NguyenQBao/UBHacking2026-MERC.SWEEPY/software/metalsweep-control/requirements-model.txt

# Install in a --system-site-packages venv on Raspberry Pi OS; apt supplies Picamera2/OpenCV/GPIO.
ultralytics==8.4.194
