NguyenQBao/UBHacking2026-MERC.SWEEPY/docs/concept/metalsweep-metal-robot-concept.png

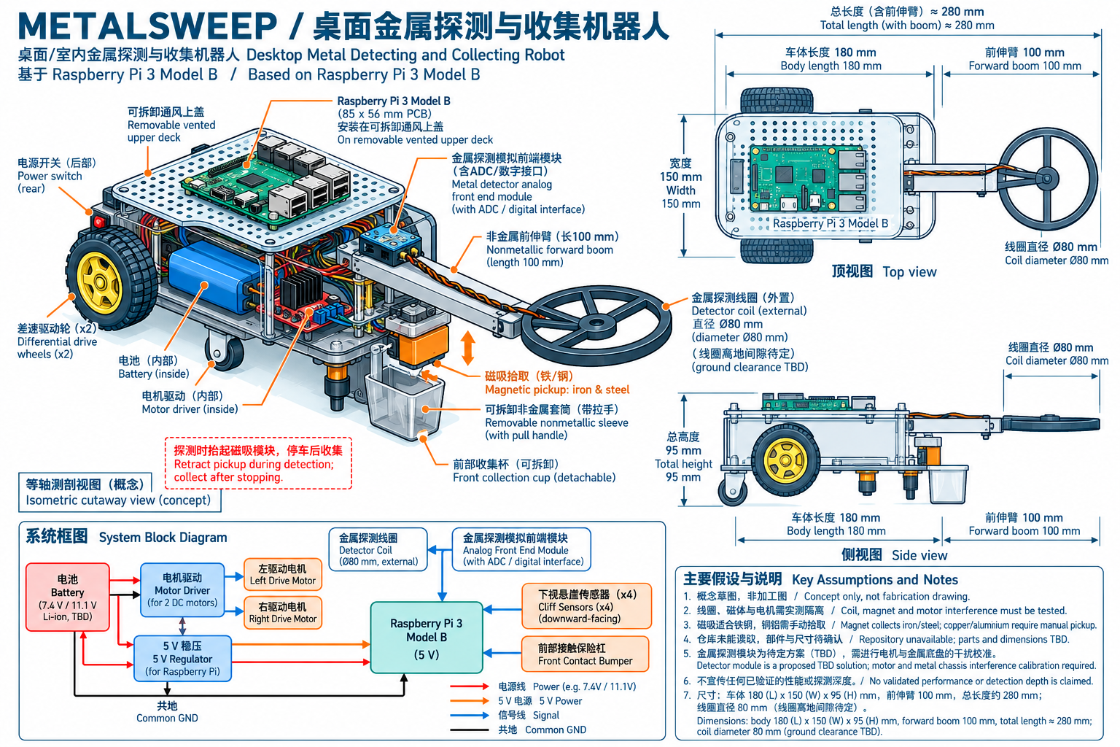
docs/concept/metalsweep-metal-robot-concept.png
