NguyenQBao/UBHacking2026-MERC.SWEEPY/docs/poster/system-flow.png

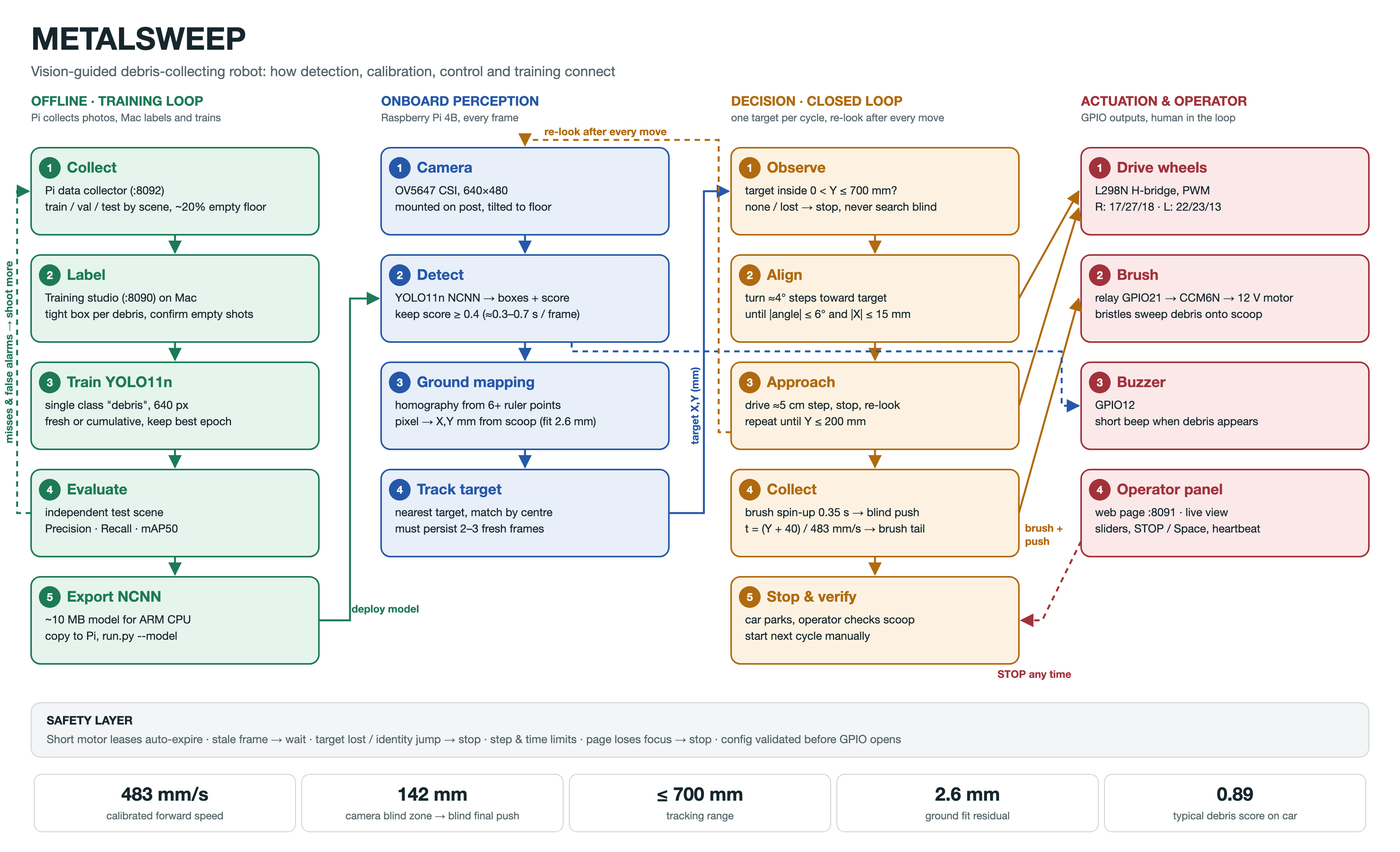
docs/poster/system-flow.png
