NguyenQBao/UBHacking2026-MERC.SWEEPY/hardware/brush-collector-v3/parts_preview.png

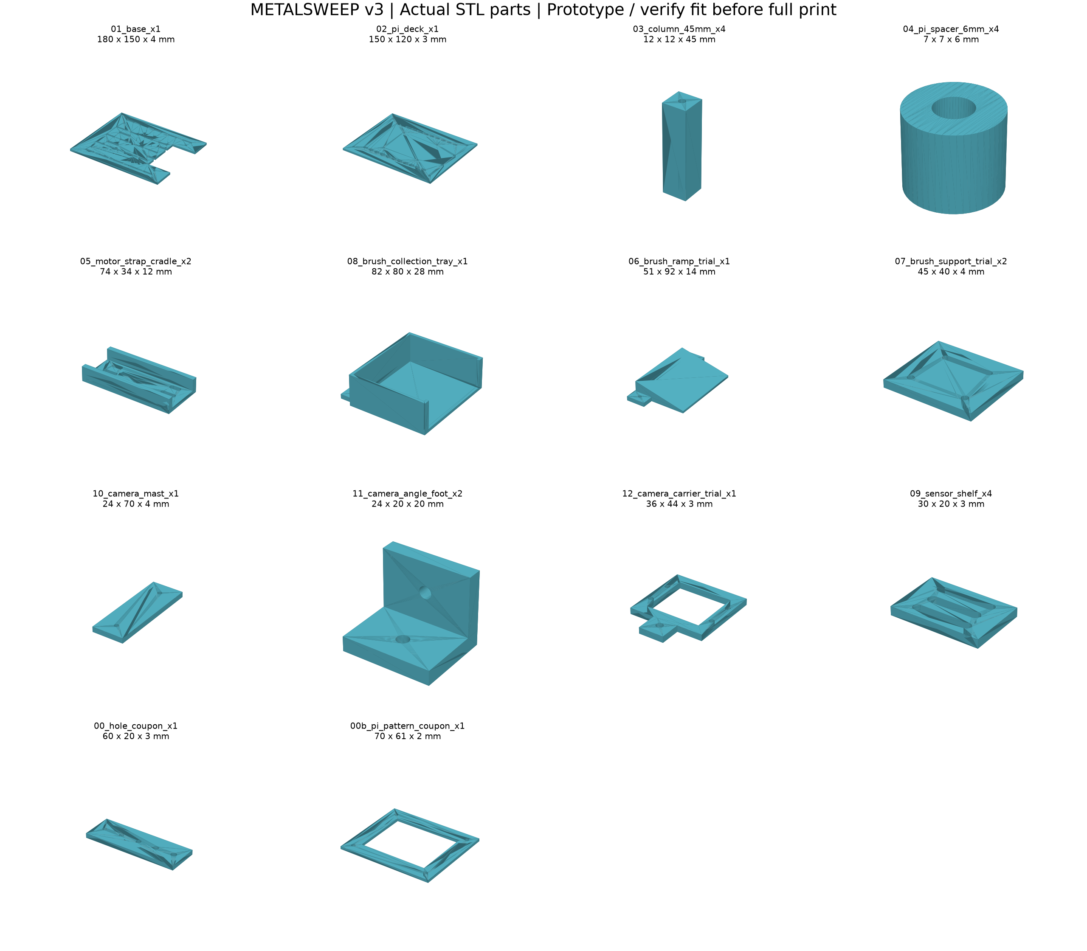
hardware/brush-collector-v3/parts_preview.png
