NguyenQBao/UBHacking2026-MERC.SWEEPY/hardware/cad-v8/ramp-main.stl

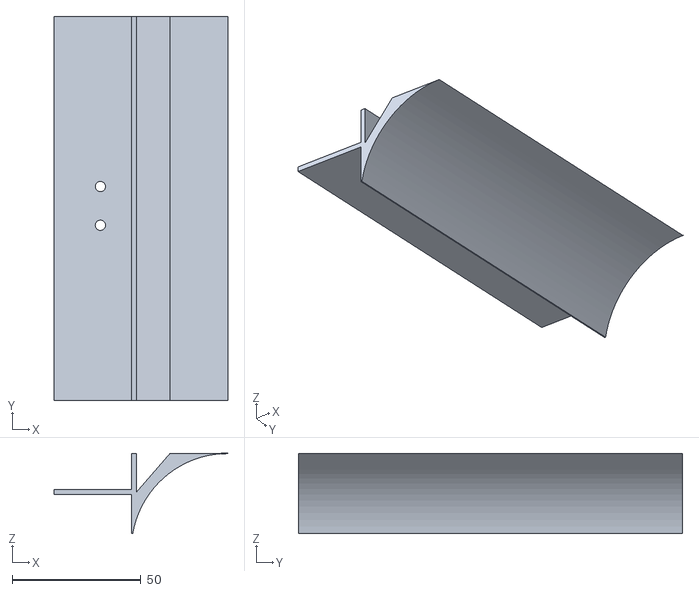
[picture p5: CAD file, 2026-11-06]
hardware/cad-v8/ramp-main.stl
67.5 x 149.0 x 31.1
