NguyenQBao/UBHacking2026-MERC.SWEEPY/hardware/cad-v8/metal-storage-main.stl

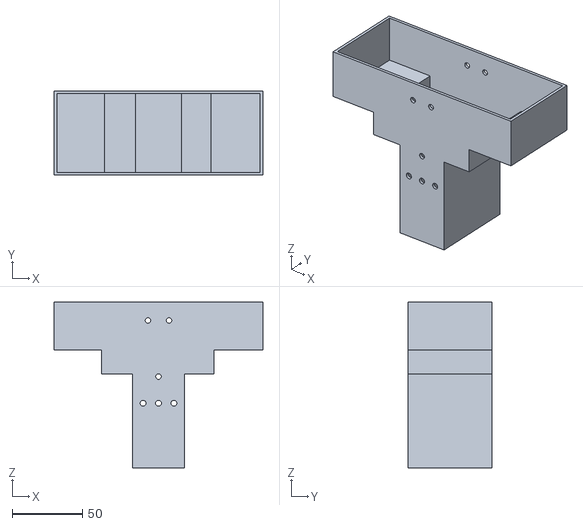
[picture p6: CAD file, 2026-11-06]
hardware/cad-v8/metal-storage-main.stl
149.0 x 60.0 x 118.0
