NguyenQBao/UBHacking2026-MERC.SWEEPY/hardware/cad-v8/shaft-main.stl

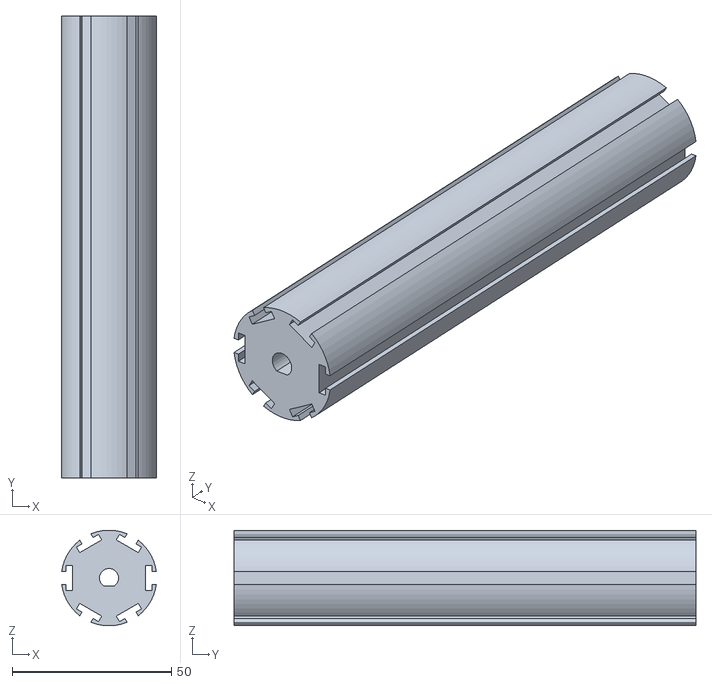
[picture p7: CAD file, 2026-11-06]
hardware/cad-v8/shaft-main.stl
29.7 x 145.0 x 30.0
