NguyenQBao/UBHacking2026-MERC.SWEEPY/hardware/brush-collector-v3/07_brush_support_trial_x2.stl

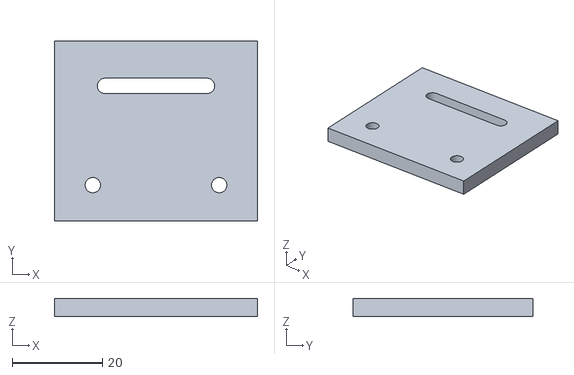
[picture p8: CAD file, 2026-11-05]
hardware/brush-collector-v3/07_brush_support_trial_x2.stl
45.0 x 40.0 x 4.00
