NguyenQBao/UBHacking2026-MERC.SWEEPY/hardware/cad-v8/camera-holder-vertical.stl

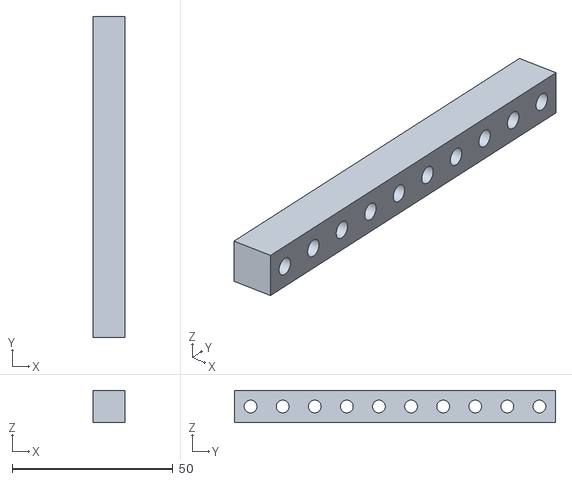
[picture p9: CAD file, 2026-11-06]
hardware/cad-v8/camera-holder-vertical.stl
10.0 x 100.0 x 10.0
