NguyenQBao/UBHacking2026-MERC.SWEEPY/hardware/camera-slot-mount/camera-slot-mount-variants.3mf

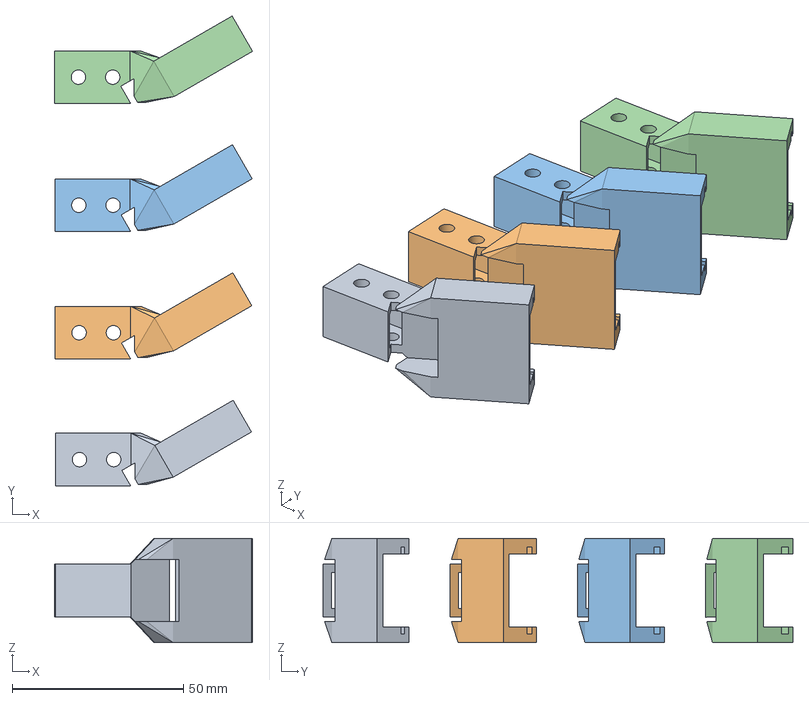
[picture p10: CAD file, 2026-11-07]
hardware/camera-slot-mount/camera-slot-mount-variants.3mf
57.8 x 137.2 x 30.4 mm
camera-slot-mount-slot1.2mm
camera-slot-mount-slot1.6mm
camera-slot-mount-slot2.0mm
camera-slot-mount-slot2.4mm
