NguyenQBao/UBHacking2026-MERC.SWEEPY/hardware/camera-slot-mount/variants/camera-slot-mount-slot1.6mm.stl

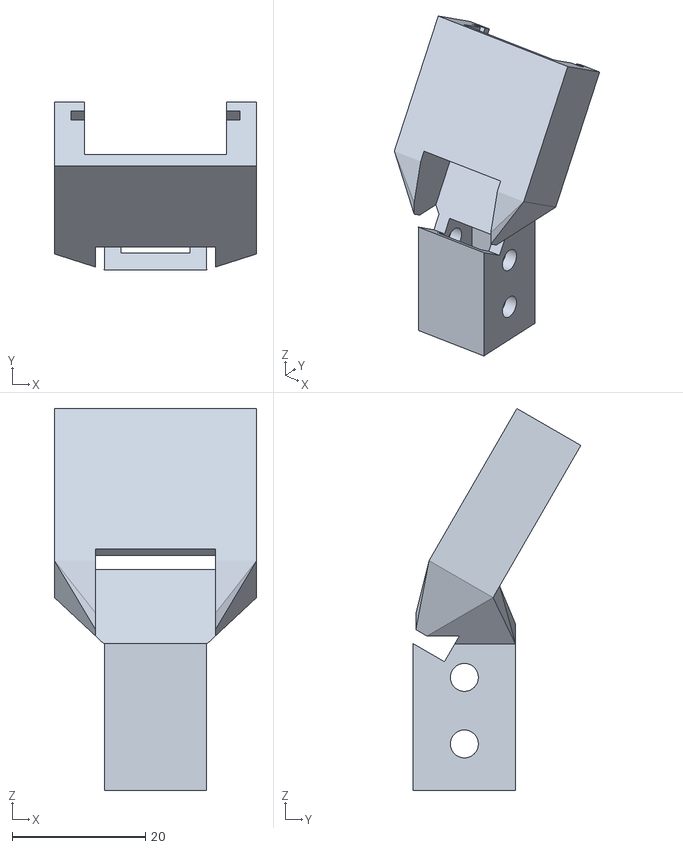
[picture p11: CAD file, 2026-11-07]
hardware/camera-slot-mount/variants/camera-slot-mount-slot1.6mm.stl
30.4 x 25.2 x 57.4
