NguyenQBao/UBHacking2026-MERC.SWEEPY/hardware/brush-collector-v3/01_base_x1.stl

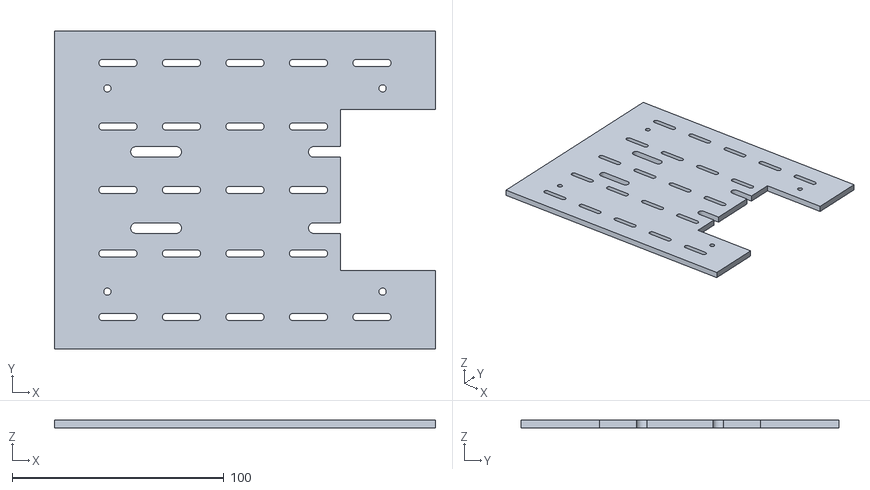
[picture p12: CAD file, 2026-11-05]
hardware/brush-collector-v3/01_base_x1.stl
180.0 x 150.0 x 4.00
