NguyenQBao/UBHacking2026-MERC.SWEEPY/hardware/camera-mount-v7/07_camera_edge_shim_0p4_optional.stl

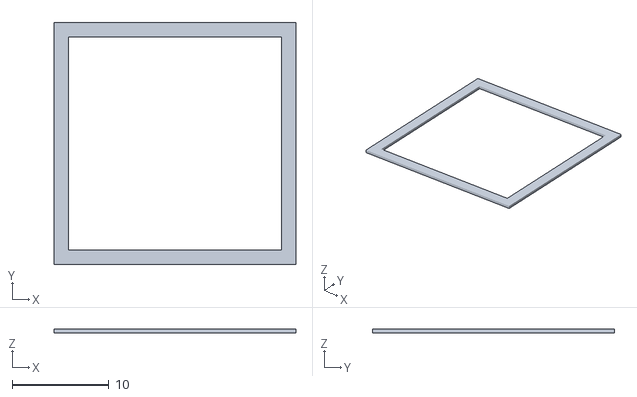
[picture p13: CAD file, 2026-11-05]
hardware/camera-mount-v7/07_camera_edge_shim_0p4_optional.stl
25.0 x 25.0 x 0.4
