NguyenQBao/UBHacking2026-MERC.SWEEPY/hardware/camera-slot-mount/variants/camera-slot-mount-slot2.4mm.stl

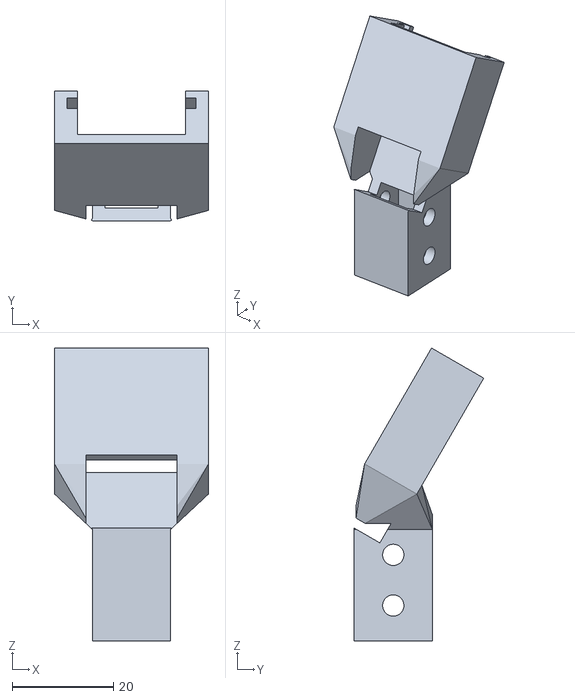
[picture p14: CAD file, 2026-11-07]
hardware/camera-slot-mount/variants/camera-slot-mount-slot2.4mm.stl
30.4 x 25.6 x 57.8
