NguyenQBao/UBHacking2026-MERC.SWEEPY/hardware/brush-collector-v3/09_sensor_shelf_x4.stl

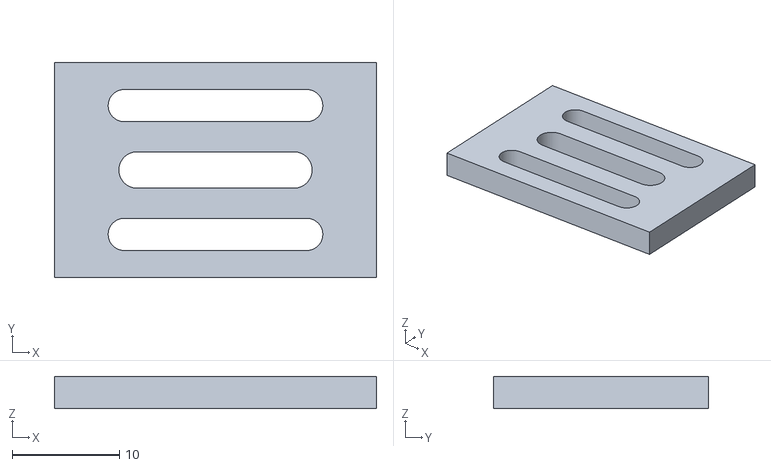
[picture p15: CAD file, 2026-11-05]
hardware/brush-collector-v3/09_sensor_shelf_x4.stl
30.0 x 20.0 x 3.00
