NguyenQBao/UBHacking2026-MERC.SWEEPY/hardware/brush-collector-v3/12_camera_carrier_trial_x1.stl

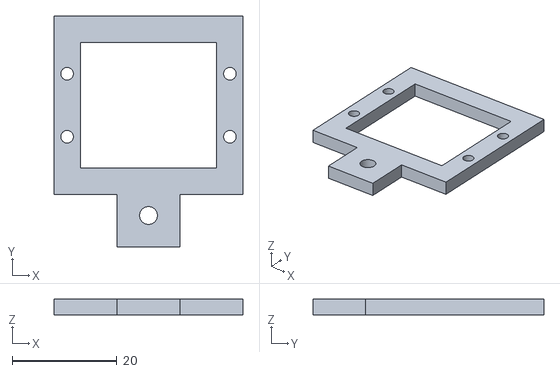
[picture p17: CAD file, 2026-11-05]
hardware/brush-collector-v3/12_camera_carrier_trial_x1.stl
36.0 x 44.0 x 3.00
