NguyenQBao/UBHacking2026-MERC.SWEEPY/hardware/camera-slot-mount/variants/camera-slot-mount-slot2.0mm.stl

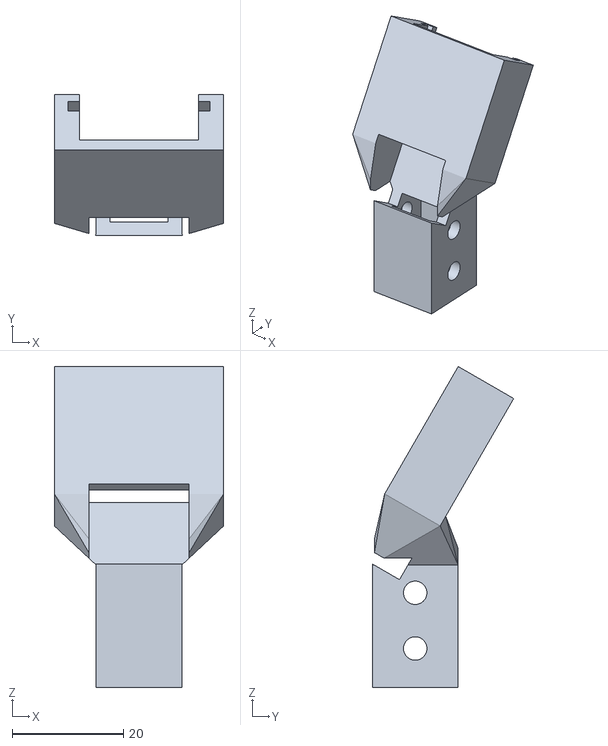
[picture p18: CAD file, 2026-11-07]
hardware/camera-slot-mount/variants/camera-slot-mount-slot2.0mm.stl
30.4 x 25.4 x 57.6
