NguyenQBao/UBHacking2026-MERC.SWEEPY/hardware/brush-collector-v3/10_camera_mast_x1.stl

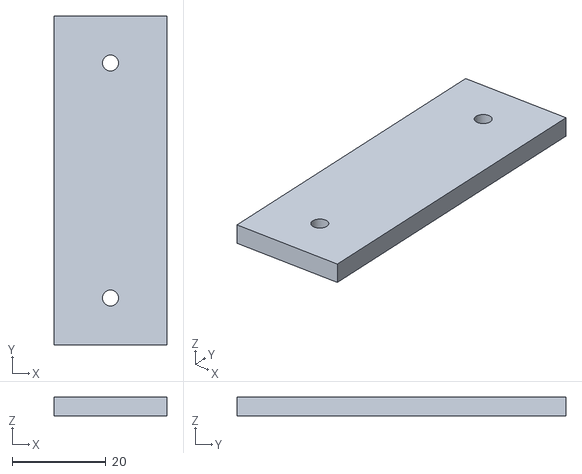
[picture p19: CAD file, 2026-11-05]
hardware/brush-collector-v3/10_camera_mast_x1.stl
24.0 x 70.0 x 4.00
