NguyenQBao/UBHacking2026-MERC.SWEEPY/hardware/cad-v8/camera-holder-front.stl

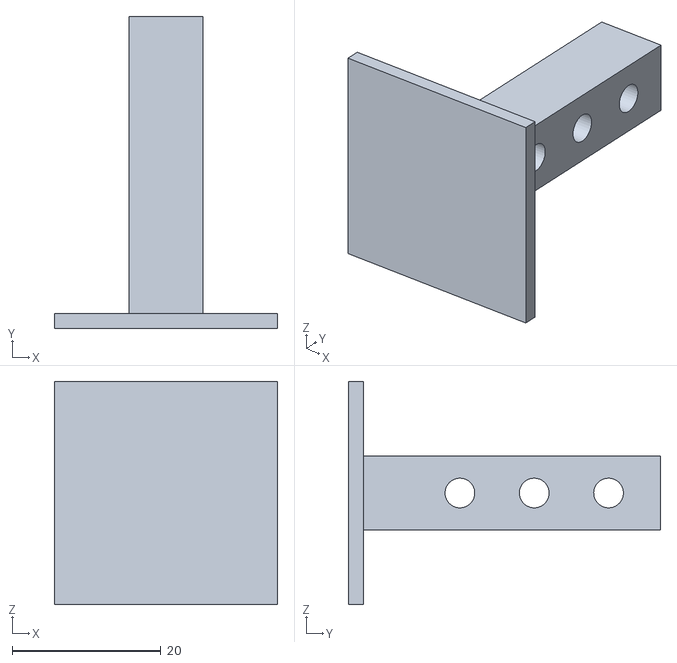
[picture p20: CAD file, 2026-11-06]
hardware/cad-v8/camera-holder-front.stl
30.0 x 42.0 x 30.0
