NguyenQBao/UBHacking2026-MERC.SWEEPY/hardware/camera-mount-v7/03_camera25_pitch_frame_x1.stl

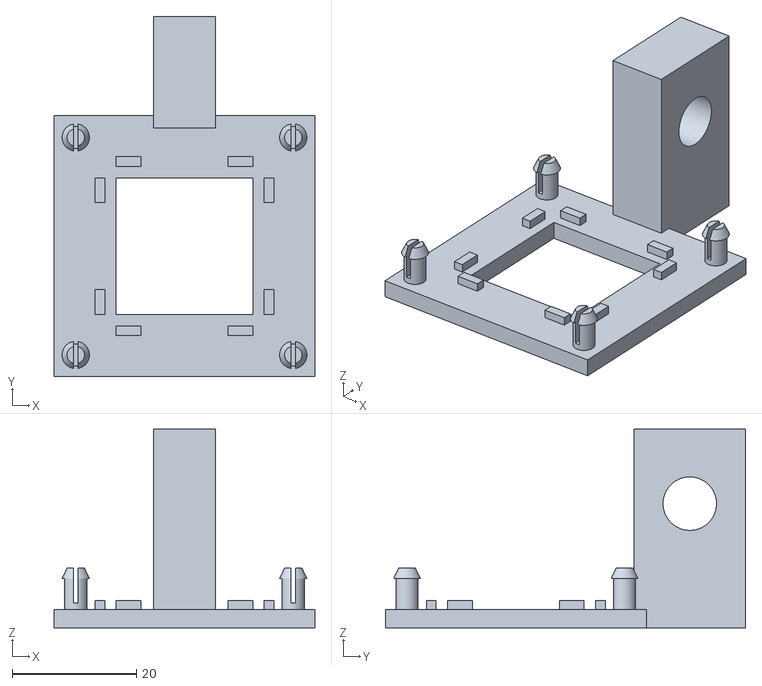
[picture p21: CAD file, 2026-11-05]
hardware/camera-mount-v7/03_camera25_pitch_frame_x1.stl
42.0 x 58.0 x 32.0
