NguyenQBao/UBHacking2026-MERC.SWEEPY/hardware/brush-collector-v3/04_pi_spacer_6mm_x4.stl

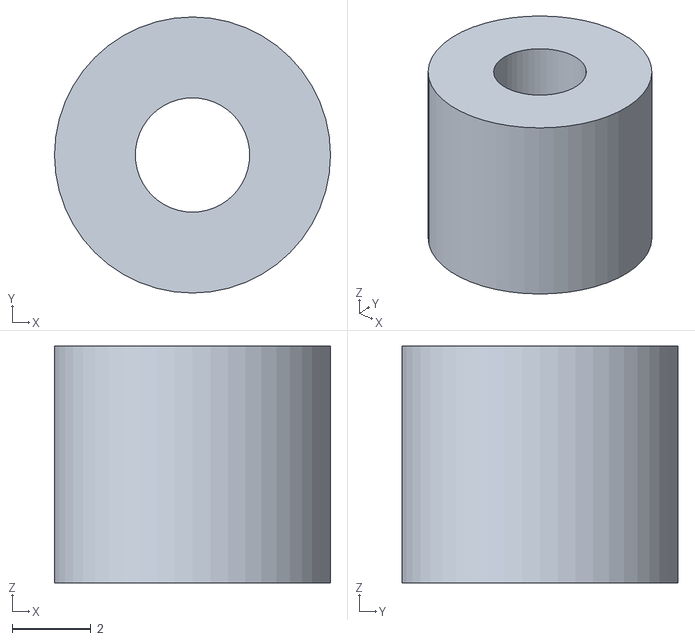
[picture p22: CAD file, 2026-11-05]
hardware/brush-collector-v3/04_pi_spacer_6mm_x4.stl
7.00 x 7.00 x 6.00
