NguyenQBao/UBHacking2026-MERC.SWEEPY/hardware/cad-v8/cleaning-wheel.stl

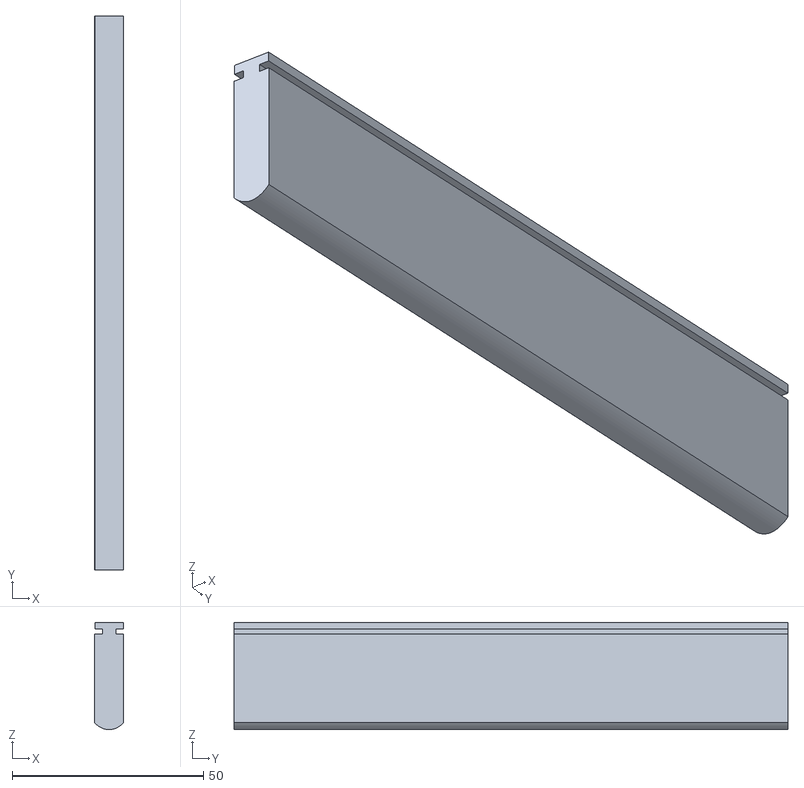
[picture p23: CAD file, 2026-11-06]
hardware/cad-v8/cleaning-wheel.stl
7.60 x 145.0 x 28.1
