NguyenQBao/UBHacking2026-MERC.SWEEPY/hardware/brush-collector-v3/03_column_45mm_x4.stl

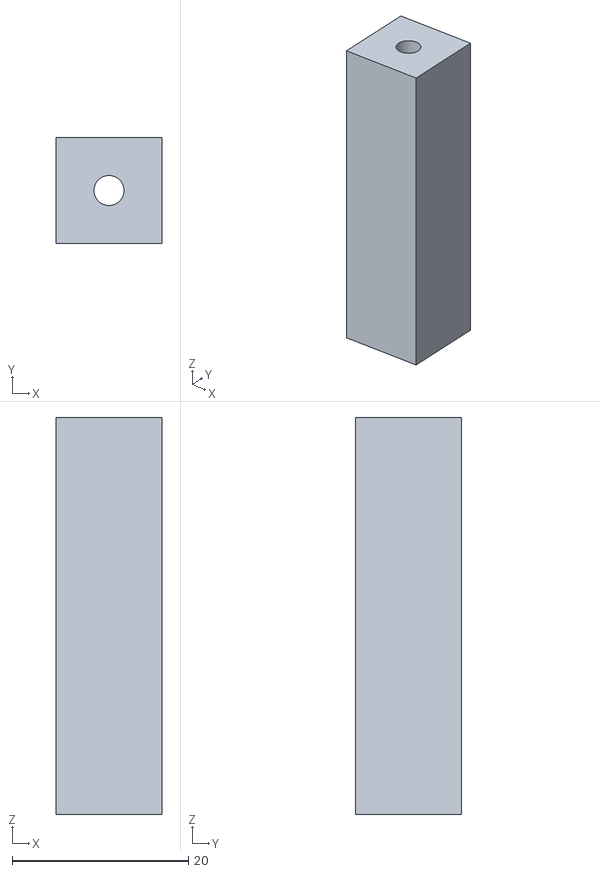
[picture p25: CAD file, 2026-11-05]
hardware/brush-collector-v3/03_column_45mm_x4.stl
12.0 x 12.0 x 45.0
