NguyenQBao/UBHacking2026-MERC.SWEEPY/hardware/cad-v8/camera-holder-horizontal.stl

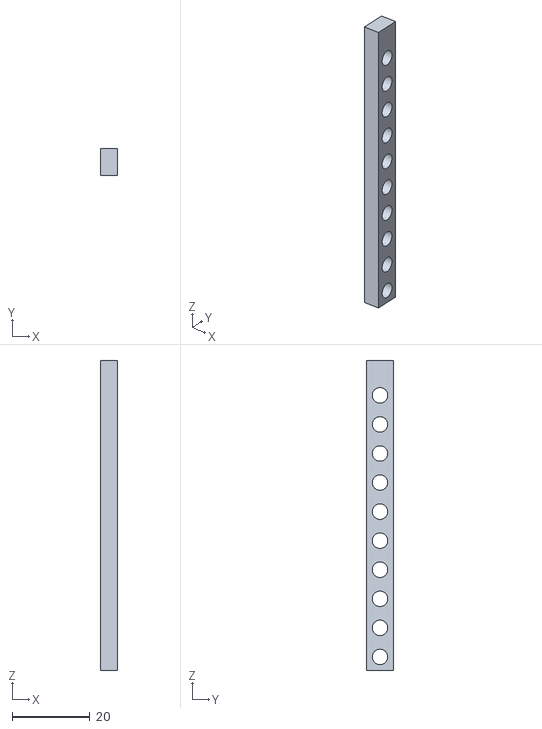
[picture p26: CAD file, 2026-11-06]
hardware/cad-v8/camera-holder-horizontal.stl
4.50 x 7.00 x 80.0
