NguyenQBao/UBHacking2026-MERC.SWEEPY/hardware/brush-collector-v3/11_camera_angle_foot_x2.stl

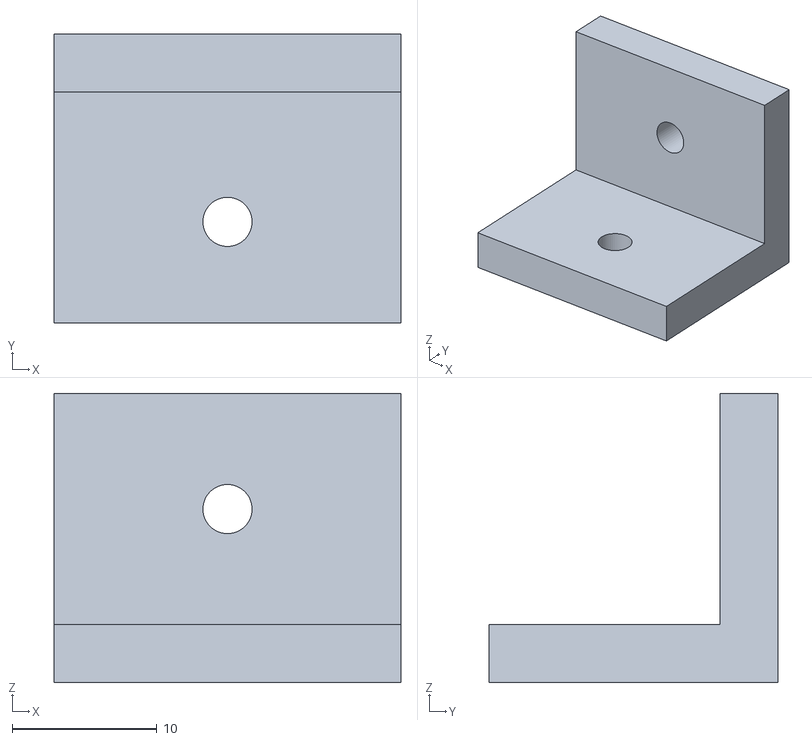
[picture p27: CAD file, 2026-11-05]
hardware/brush-collector-v3/11_camera_angle_foot_x2.stl
24.0 x 20.0 x 20.0
