NguyenQBao/UBHacking2026-MERC.SWEEPY/hardware/brush-collector-v3/05_motor_strap_cradle_x2.stl

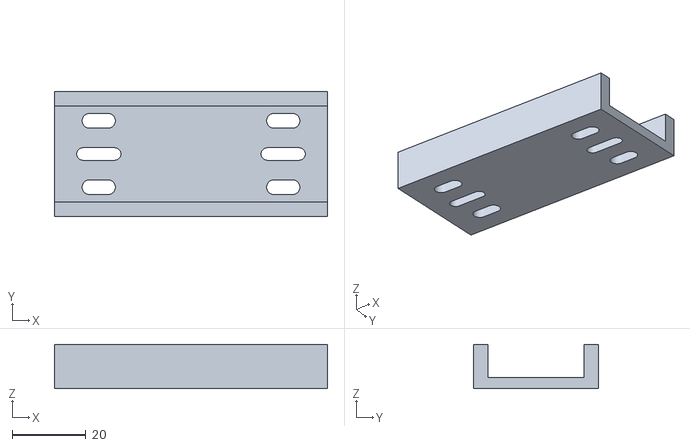
[picture p29: CAD file, 2026-11-05]
hardware/brush-collector-v3/05_motor_strap_cradle_x2.stl
74.0 x 34.0 x 12.0
