NguyenQBao/UBHacking2026-MERC.SWEEPY/hardware/camera-mount-v7/04_camera_back_retainer_x1.stl

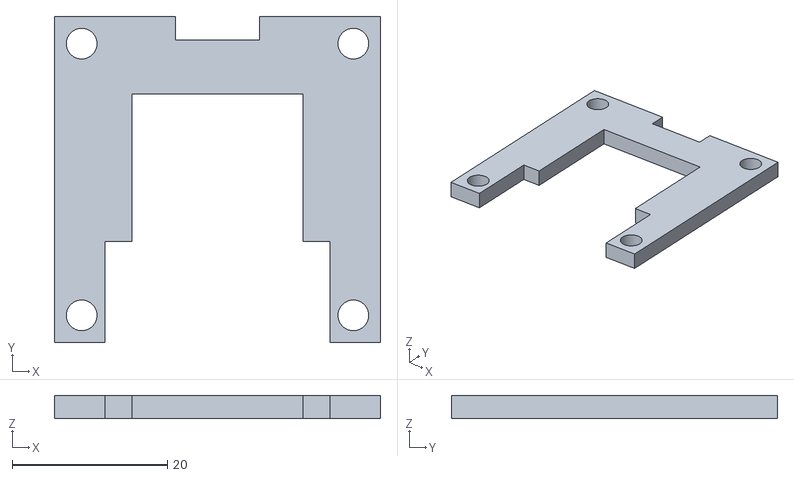
[picture p30: CAD file, 2026-11-05]
hardware/camera-mount-v7/04_camera_back_retainer_x1.stl
42.0 x 42.0 x 3.00
