NguyenQBao/UBHacking2026-MERC.SWEEPY/hardware/brush-collector-v3/00b_pi_pattern_coupon_x1.stl

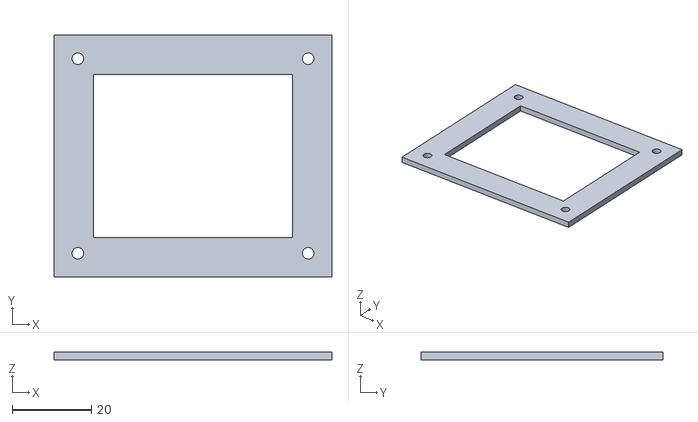
[picture p31: CAD file, 2026-11-05]
hardware/brush-collector-v3/00b_pi_pattern_coupon_x1.stl
70.0 x 61.0 x 2.00
