NguyenQBao/UBHacking2026-MERC.SWEEPY/hardware/camera-mount-v7/00c_snap_post_coupon.stl

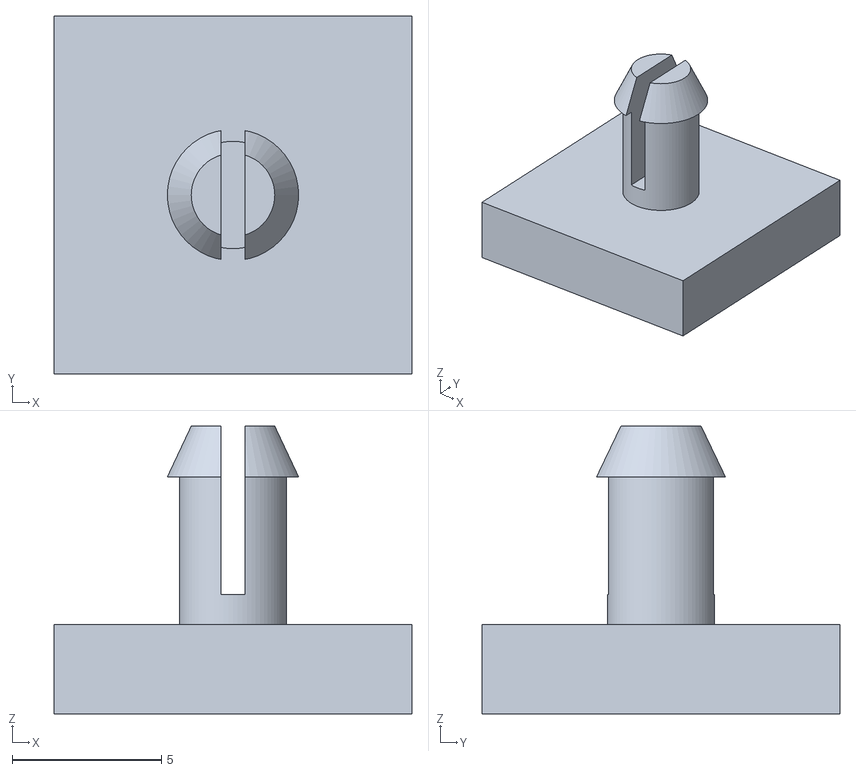
[picture p32: CAD file, 2026-11-05]
hardware/camera-mount-v7/00c_snap_post_coupon.stl
12.0 x 12.0 x 9.65
