NguyenQBao/UBHacking2026-MERC.SWEEPY/hardware/brush-collector-v3/00_hole_coupon_x1.stl

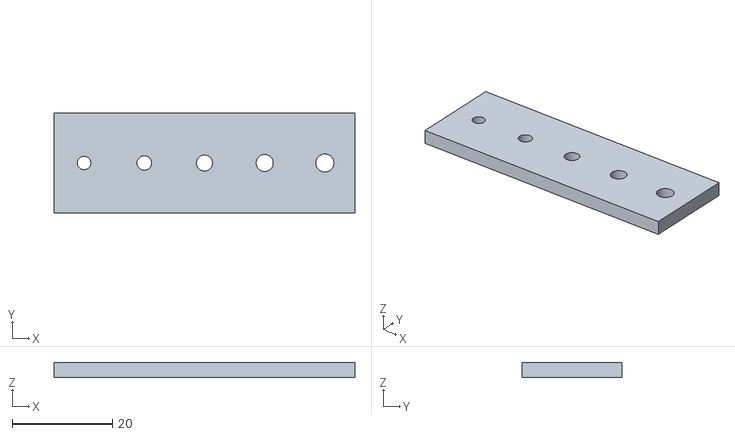
[picture p33: CAD file, 2026-11-05]
hardware/brush-collector-v3/00_hole_coupon_x1.stl
60.0 x 20.0 x 3.00
