NguyenQBao/UBHacking2026-MERC.SWEEPY/hardware/brush-collector-v3/08_brush_collection_tray_x1.stl

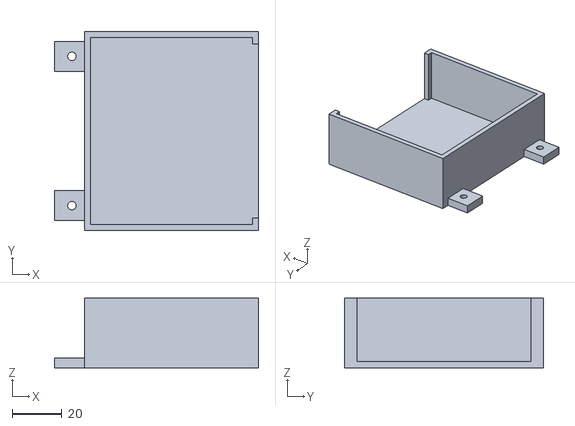
[picture p34: CAD file, 2026-11-05]
hardware/brush-collector-v3/08_brush_collection_tray_x1.stl
82.0 x 80.0 x 28.0
