NguyenQBao/UBHacking2026-MERC.SWEEPY/hardware/brush-collector-v3/06_brush_ramp_trial_x1.stl

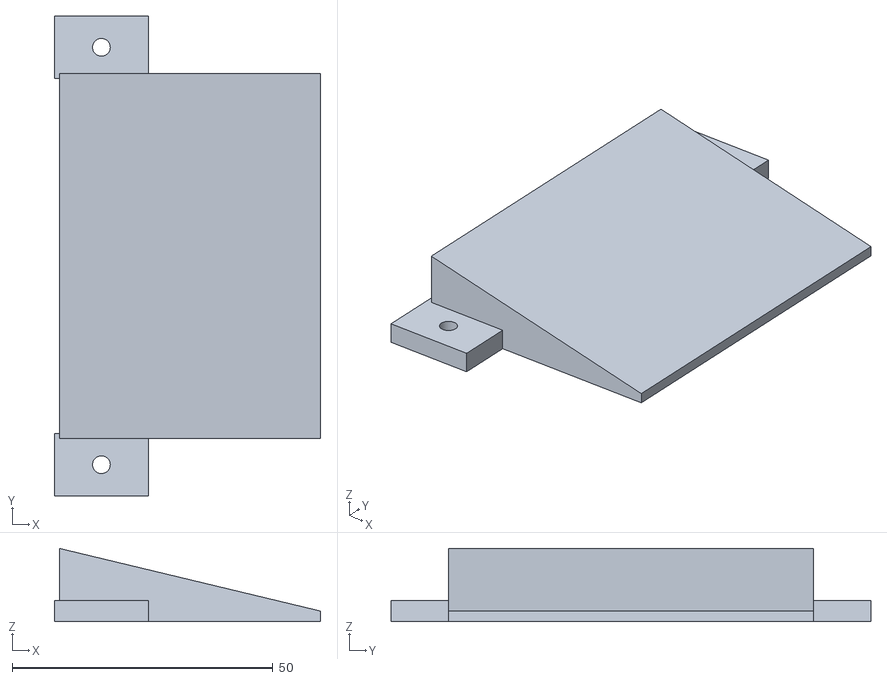
[picture p35: CAD file, 2026-11-05]
hardware/brush-collector-v3/06_brush_ramp_trial_x1.stl
51.0 x 92.0 x 14.0
