NguyenQBao/UBHacking2026-MERC.SWEEPY/hardware/brush-collector-v3/02_pi_deck_x1.stl

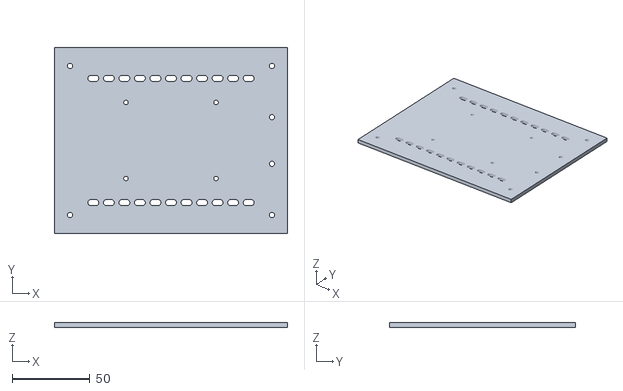
[picture p36: CAD file, 2026-11-05]
hardware/brush-collector-v3/02_pi_deck_x1.stl
150.0 x 120.0 x 3.00
