NguyenQBao/UBHacking2026-MERC.SWEEPY/hardware/camera-mount-v7/02_mast_90mm_forward45_choose_one.stl

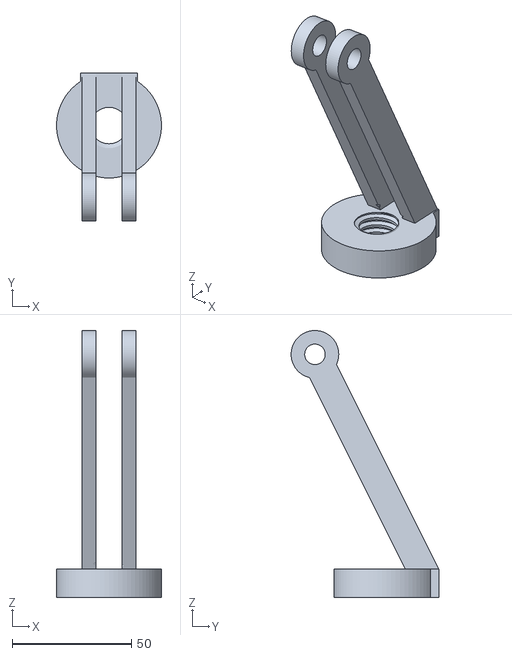
[picture p37: CAD file, 2026-11-05]
hardware/camera-mount-v7/02_mast_90mm_forward45_choose_one.stl
44.0 x 62.0 x 112.0
