NguyenQBao/UBHacking2026-MERC.SWEEPY/hardware/camera-mount-v7/00c_snap_retainer_coupon.stl

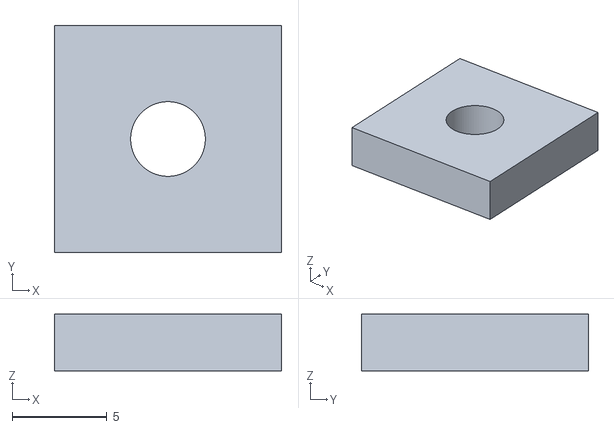
[picture p39: CAD file, 2026-11-05]
hardware/camera-mount-v7/00c_snap_retainer_coupon.stl
12.0 x 12.0 x 3.00
