NguyenQBao/UBHacking2026-MERC.SWEEPY/hardware/camera-mount-v7/02_mast_120mm_choose_one.stl

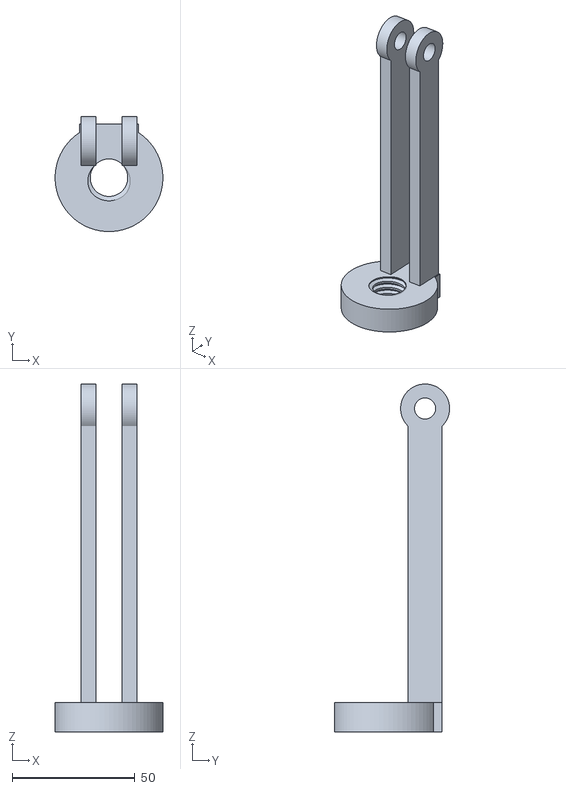
[picture p40: CAD file, 2026-11-05]
hardware/camera-mount-v7/02_mast_120mm_choose_one.stl
44.0 x 47.0 x 142.0
