NguyenQBao/UBHacking2026-MERC.SWEEPY/(list of files, cad)

Other CAD files:
hardware/camera-slot-mount/variants/camera-slot-mount-slot1.2mm.stl
hardware/camera-mount-v7/00a_base_thread_nut_coupon.stl
hardware/camera-mount-v7/00a_base_thread_screw_coupon.stl
hardware/camera-mount-v7/00b_pitch_thread_nut_coupon.stl
hardware/camera-mount-v7/00b_pitch_thread_screw_coupon.stl
hardware/camera-mount-v7/01_base_clamp_screw_x1.stl
hardware/camera-mount-v7/05_pitch_thumb_screw_x1.stl
hardware/camera-mount-v7/06_pitch_thumb_nut_x1.stl
