NguyenQBao/UBHacking2026-MERC.SWEEPY/hardware/brush-collector-v3/assembly_page_2.png

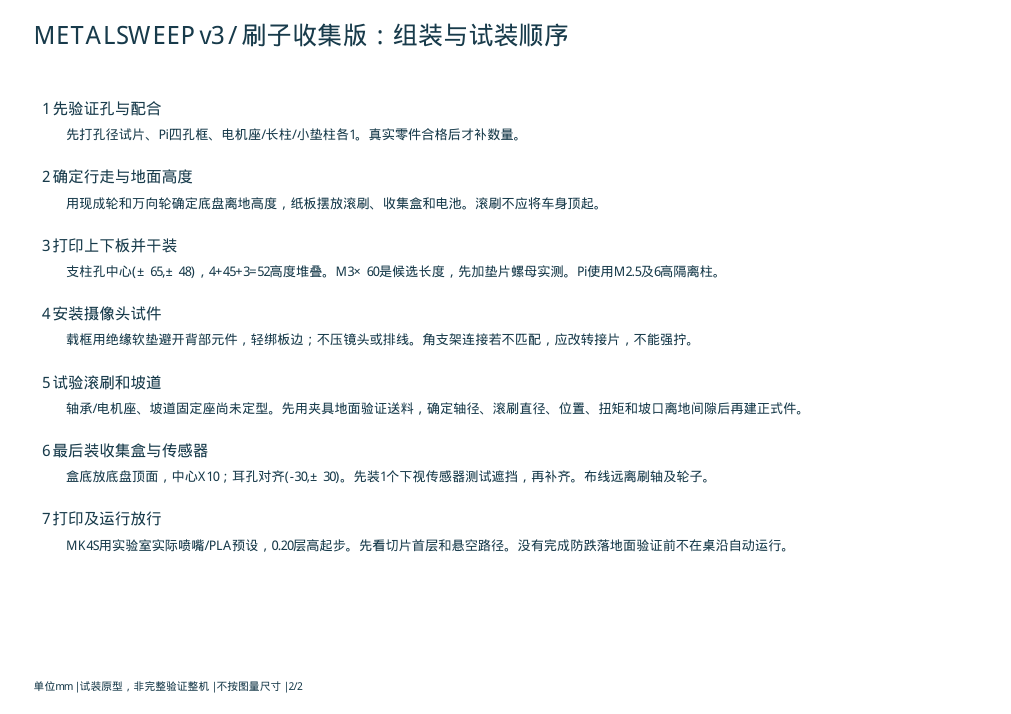
hardware/brush-collector-v3/assembly_page_2.png
