NguyenQBao/UBHacking2026-MERC.SWEEPY/hardware/camera-mount-v7/assembly_preview.png

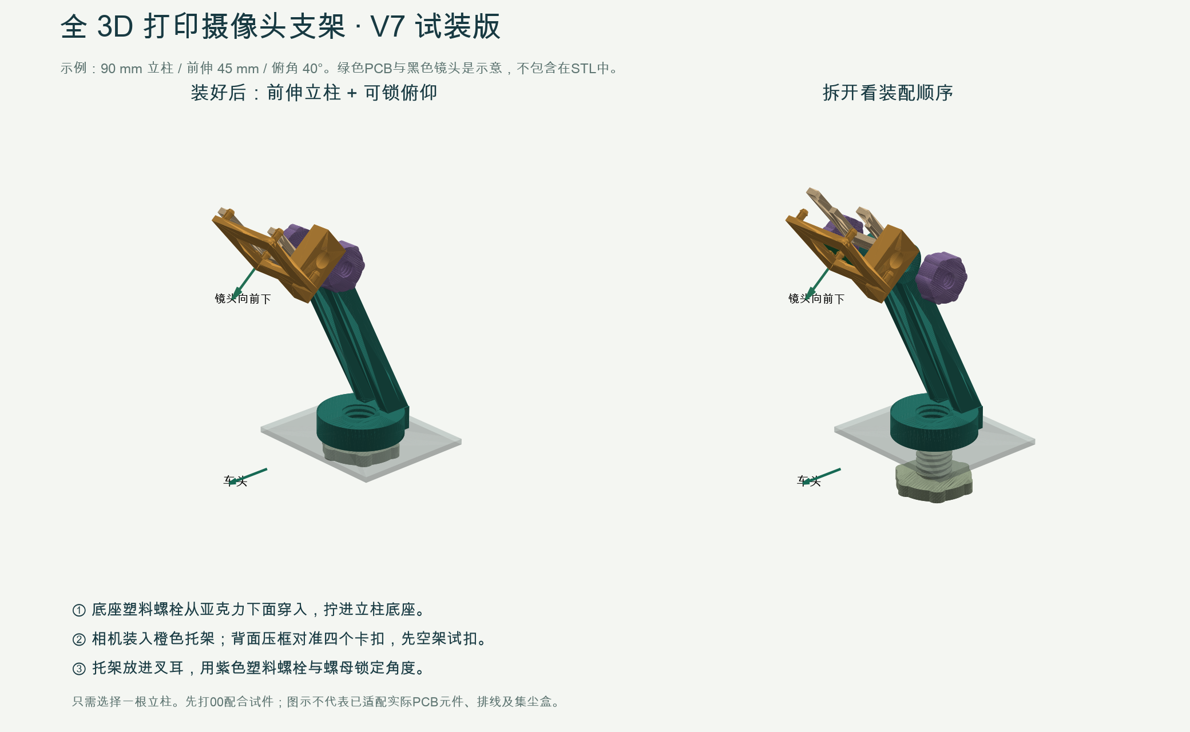
hardware/camera-mount-v7/assembly_preview.png
