NguyenQBao/UBHacking2026-MERC.SWEEPY/hardware/wiring/pi4b-l298n-wiring-page1.png

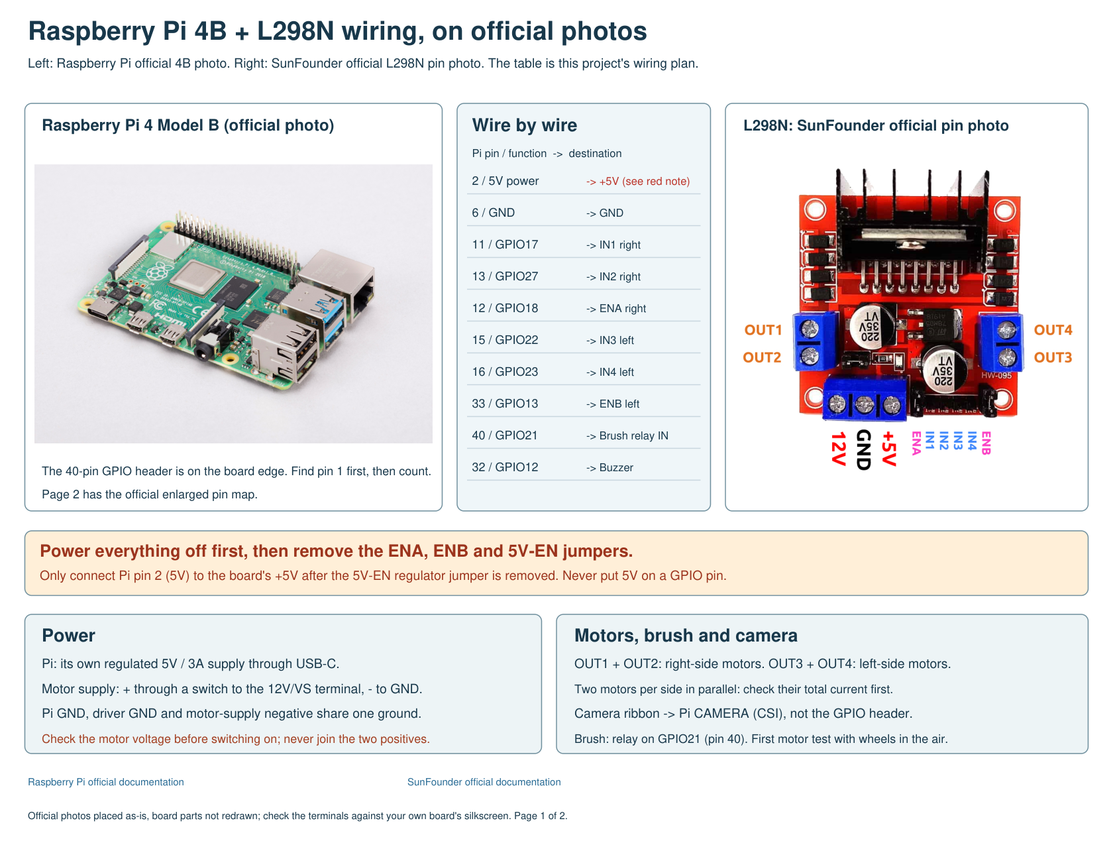
hardware/wiring/pi4b-l298n-wiring-page1.png
