NguyenQBao/UBHacking2026-MERC.SWEEPY/(commit log)

2026-11-05 Organize METALSWEEP software, CAD models, wiring and project documentation
    [00_hole_coupon_x1.stl, 00a_base_thread_nut_coupon.stl, 00a_base_thread_screw_coupon.stl, 00a_clevis_coupon_x1.stl, 00a_fit_wall_coupon_x1.stl, 00a_post19p4_fit_coupon_x1.stl, 00b_ear_coupon_x1.stl, 00b_fit_lid_coupon_x1.stl]
2026-11-06 Replace current CAD with V8 models; archive camera-mount-v7 and brush-collector-v3
    [00_hole_coupon_x1.stl, 00a_base_thread_nut_coupon.stl, 00a_base_thread_screw_coupon.stl, 00b_pi_pattern_coupon_x1.stl, 00b_pitch_thread_nut_coupon.stl, 00b_pitch_thread_screw_coupon.stl, 00c_snap_post_coupon.stl, 00c_snap_retainer_coupon.stl]
2026-11-06 Add V8 collector assembly photo and layout notes
2026-11-06 Document 11.1V 3S battery and power constraints
2026-11-06 Document shared-battery power layout, budget and cautions
2026-11-06 Brush motor is TS-25GAH370-20 (12V 300rpm), replacing JGB37-520 notes
2026-11-06 Camera is Hiwonder TY-9251-OV5 on CSI ribbon, not USB
2026-11-06 Assign kit buck converter to TT wheels; separate 5V module for Pi
2026-11-07 Match actual wiring: ENB on GPIO13, brush relay moved to GPIO19
2026-11-07 Match real car: swap wheel sides, invert left, stronger pulses; log turn test
    [test_control.py]
2026-11-07 Document 12V relay module for brush and correct LM2596 voltage
2026-11-07 Control page: brush test panel and wheel/turn tuning sliders
    Adds set/brush_test/save commands (bounded by config validation),
    English UI sections for wheels and brush, and HTTP tests.
2026-11-07 Move brush relay (power on/off module) to GPIO21 per real wiring
2026-11-07 Add camera slot mount for the 10mm post and GPIO12 debris buzzer
    - hardware/camera-slot-mount: parametric generator + STL (slide-in PCB cradle,
    30 deg tilt, sleeve over post with holes aligned to the post's 4 mm holes)
    - control: Buzzer beeps once on each new debris detection (rate-limited),
    config 'buzzer' section, defaults to GPIO12 when absent
    [camera-slot-mount.stl]
2026-11-07 Camera slot mount: widen board slot to 2.0 mm
    [camera-slot-mount.stl]
2026-11-07 Camera slot mount README: correct outer size
2026-11-07 Camera slot mount: 1.2-2.4 mm slot variants and PrusaSlicer plate with supports
    [camera-slot-mount-slot1.2mm.stl, camera-slot-mount-slot1.6mm.stl, camera-slot-mount-slot2.0mm.stl, camera-slot-mount-slot2.4mm.stl, camera-slot-mount-variants.3mf]
2026-11-07 Camera slot mount plate: print on side, 12 mm gaps, overlap/bed checks
    [camera-slot-mount-variants.3mf]
2026-11-07 Camera slot mount plate: organic (tree) supports
    [camera-slot-mount-variants.3mf]
2026-11-07 Set forward_mm_per_second=483 from measured 145 mm per 0.3 s step
2026-11-07 Limit detection range to measured 400 mm camera view
2026-11-07 Support 90/270 degree camera rotation (portrait 480x640)
    New config 'rotate' (0/90/180/270, replaces rotate180 which still maps to 0/180).
    Vision bounds, centre line, direction, ground calibration and page pixel
    coordinates follow the rotated frame size. Real car set to rotate=90.
    [calibrate.py, control.py, run.py, test_control.py, test_http.py, vision.py]
2026-11-07 Revert "Support 90/270 degree camera rotation (portrait 480x640)"
    The camera will be physically turned back to landscape instead.
    This reverts commit 986dd03.
    [calibrate.py, control.py, run.py, test_control.py, test_http.py, vision.py]
2026-11-07 Record camera view: 35 mm blind zone before scoop, >400 mm range
2026-11-07 Training studio: export dataset as YOLO ZIP or full workspace backup
    Web buttons (section 4) and 'workflow.py export-dataset --format yolo|backup'.
    YOLO export holds reviewed labels with a portable data.yaml (path: .);
    backup holds all photos + manifest and reopens with studio.py --root.
2026-11-07 Add Pi data collector, separate from the training studio
    software/debris-collector: capture-only page on the Pi (port 8092), photos sorted
    by split/scene with one-scene-one-split rule, progress vs 30/10/10 target,
    empty-shot tag, undo, ZIP export. Pulls frames from the running car backend
    or owns the CSI camera with --picamera. Standard library only.
    Training studio: 'import collection' button + workflow.py import-collection,
    keeping scene and split; photos arrive unreviewed for labelling.
2026-11-08 Control: optional ground_margin_px to accept targets outside the calibrated area
2026-11-08 Poster system-flow diagram (SVG, PNG, generator)
2026-11-08 Control: sound effects, collect-success check, Auto nearest / all in view
    - Named buzzer melodies (test, success, miss, all_clear, birthday) with a
    Sound section on the page; optional playback on the browser too
    - After the sweep, verify the target left the push zone: success or miss
    - Auto modes: nearest (one target) and all in view (nearest-first, up to
    max_targets, ends with ALL_COLLECTED)
    [control.py, run.py, test_control.py, test_http.py]
2026-11-08 Control: extra melodies from sounds.json and a melody importer
    - run.py loads optional sounds.json; each melody gets a button on the page
    - melody_from_python.py copies a [(hz, seconds), ...] list from a Python
    file (parsed, not executed) into sounds.json; sounds.json is gitignored
2026-11-08 Control: buzzer volume slider (0.25-0.5) and all-sounds on/off switch
    - buzzer_volume sets the passive piezo PWM duty; buzzer_enabled mutes every
    beep and melody (car and browser) and cuts a playing sound
    - Both change live without stopping Auto and are kept by Save as default
    [control.py, run.py, test_control.py]
2026-11-08 Control: final push extra slider (0-150 mm) and 1.3 s brush tail
    - entry_margin_mm is adjustable from the Auto section and saved with
    Save as default; the page shows the maximum push distance
    - Brush keeps spinning 1 s longer after the push (tail_seconds up to 2 s,
    split into motor leases of 1 s or less)
2026-11-08 Clean up the repository and switch everything to English
    - Remove unused folders: archive/ (old chassis, mounts, brush v3, demos),
    extras/ (side projects), software/debris-detector-pi4 (old colour
    detector), docs/camera-orientation, docs/source-files.json
    - Translate all docs, READMEs, verification logs, the studio launcher and
    remaining program messages to English; English file names throughout
    - Regenerate the wiring PDF/PNGs in English from make_wiring.py, updated to
    the wiring on the car (ENB pin 33, brush relay pin 40, buzzer pin 32)
    - Update docs for Auto nearest / all in view, collect check, sounds and the
    live tuning controls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
    [00_hole_coupon_x1.stl, 00a_base_thread_nut_coupon.stl, 00a_base_thread_screw_coupon.stl, 00a_clevis_coupon_x1.stl, 00a_fit_wall_coupon_x1.stl, 00a_post19p4_fit_coupon_x1.stl, 00b_ear_coupon_x1.stl, 00b_fit_lid_coupon_x1.stl]
2026-11-08 Control: play melodies like the rover buzzer.py
    - Silence before each pitch change and turn off after every note, so
    repeated notes stay separate
    - Happy Birthday is the full four-line song from buzzer.py
    [control.py, test_control.py]
